phuang1024/BoostConverter/README.md

# BoostConverter

Design, analysis, and build of a boost converter circuit.

[Paper](./paper.pdf)

## Gallery

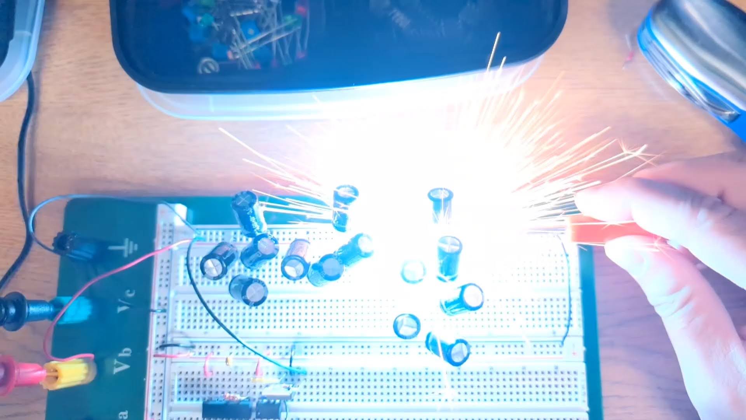
[picture p1: SparkBlue.jpg]


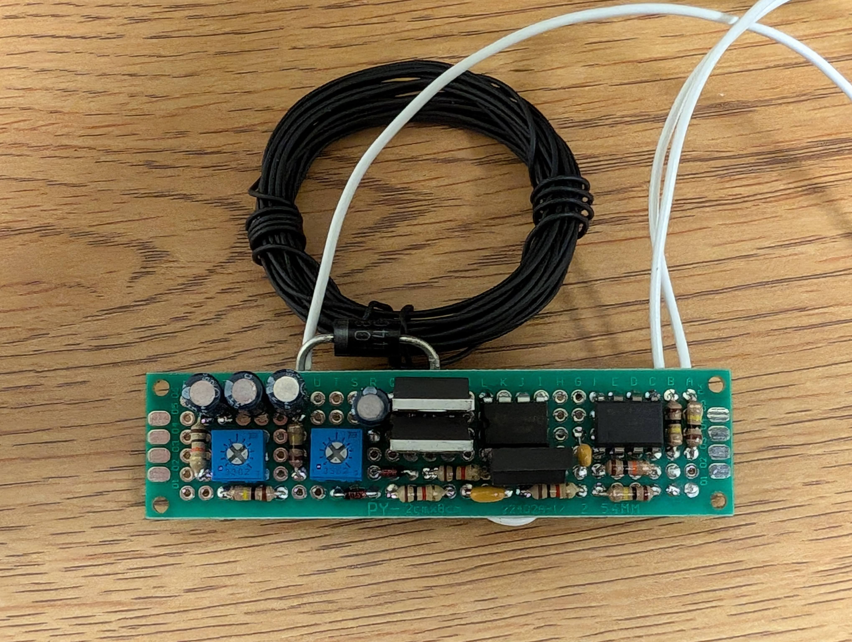
[picture p2: Protoboard.jpg]


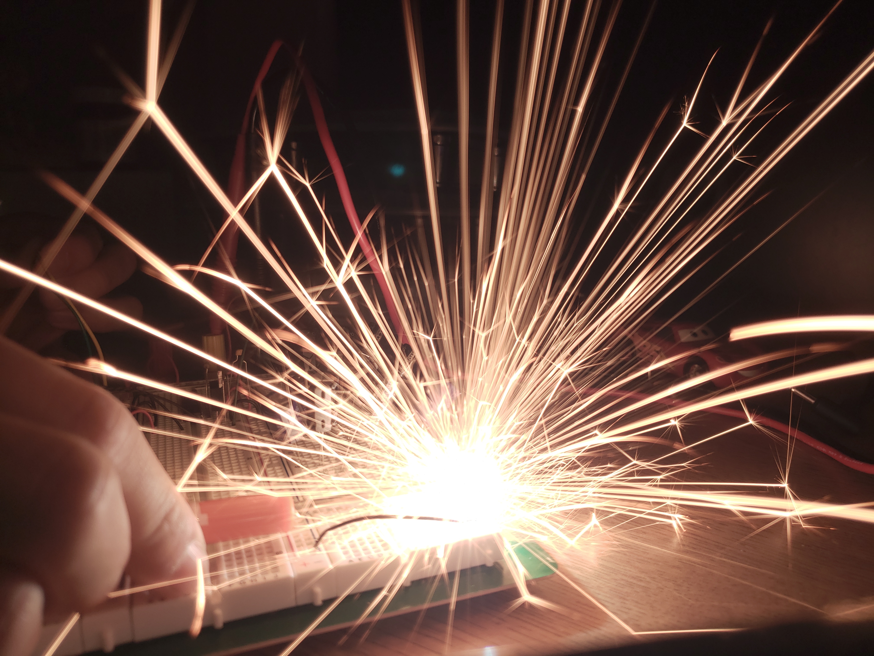
[picture p3: SparkDark.jpg]


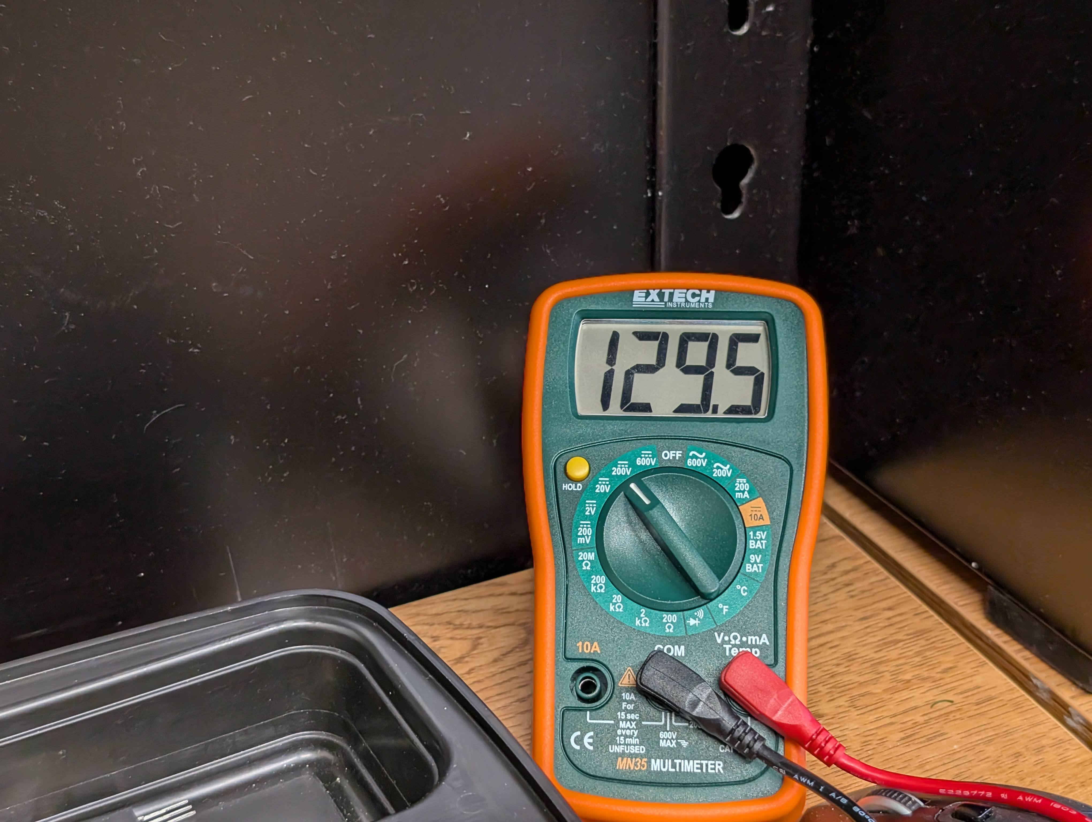
[picture p4: Voltmeter.jpg]
