phuang1024/BoostConverter/schematic.kicad_sch

## KiCad design schematic.kicad_sch (2025-01-09)

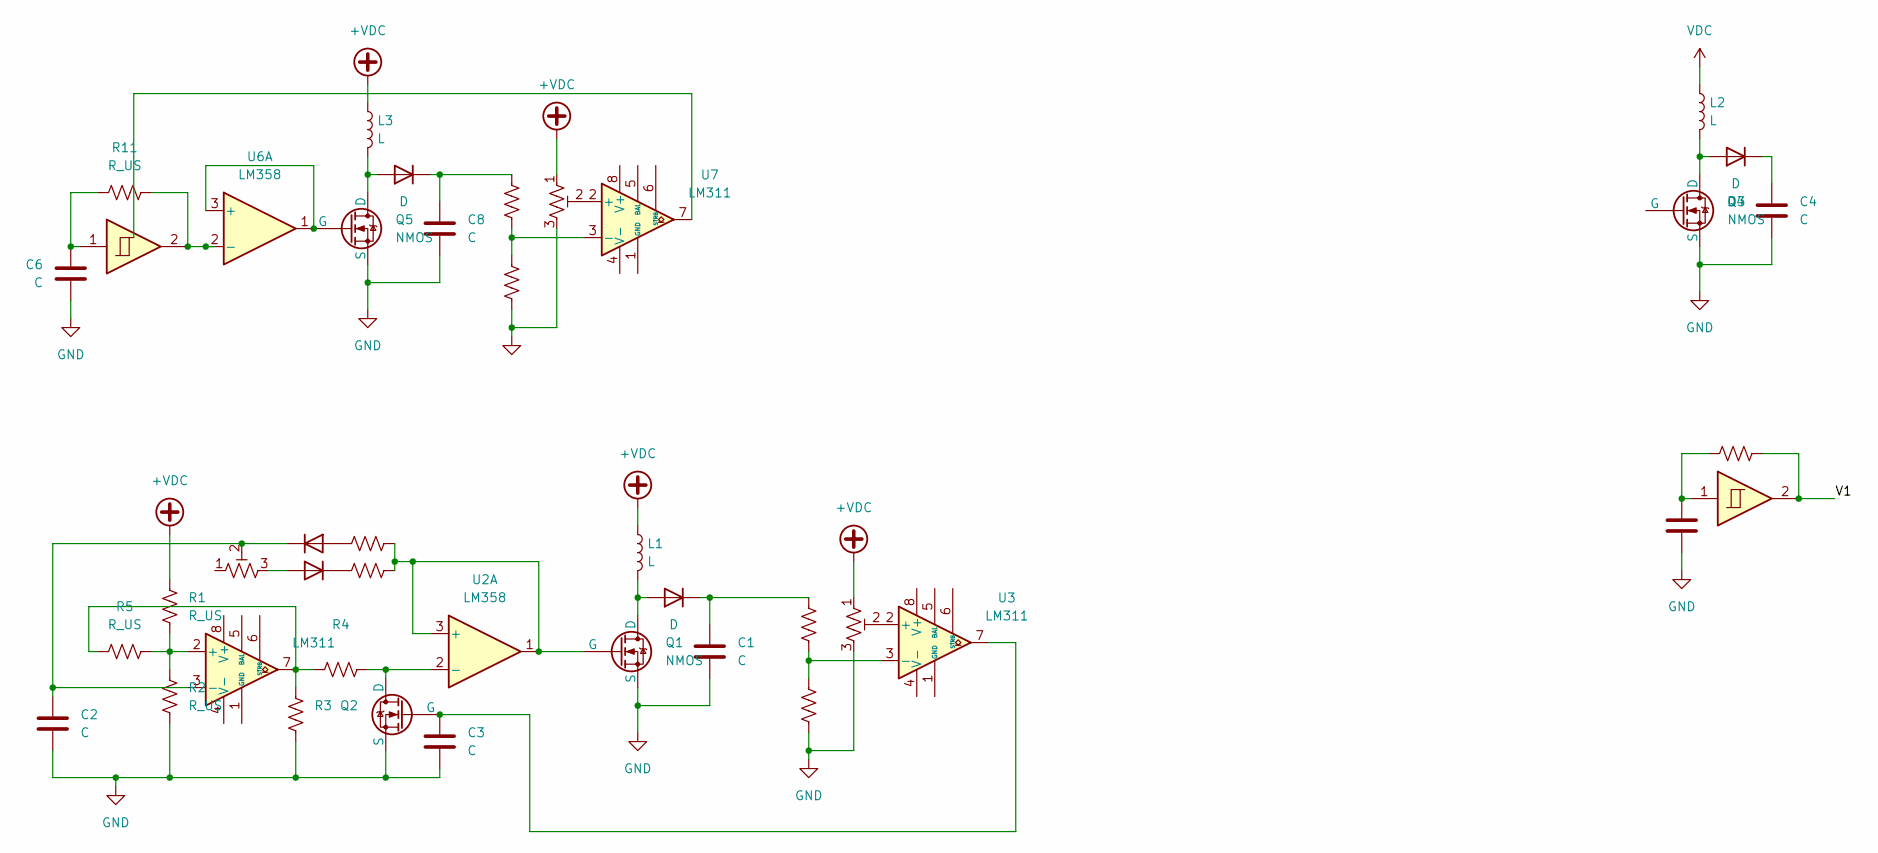
[picture p9: schematic schematic.kicad_sch]

Parts:
C1, C2, C3, C4, C5, C6, C8: C
D1, D4, D7: D
D2, D3: 1N4148WT; D_SOD-523
L1, L2, L3: L
Q1, Q2, Q3, Q5: NMOS
R1, R2, R3, R4, R5, R6, R7, R8, R9, R10, R11, R18, R19: R_US
RV1, RV2, RV4: R_Potentiometer_Trim_US
U1, U3, U7: LM311
U2, U6: LM358
U4, U5: 74HC7014; SOIC-14_3.9x8.7mm_P1.27mm

Connections:
+VDC: L1.1, L3.1, R1.1, RV2.1, RV4.1
GND: C1.2, C2.2, C3.2, C4.2, C5.2, C6.2, C8.2, Q1.3 (S), Q2.3 (S), Q3.3 (S), Q5.3 (S), R2.2, R3.2, R9.2, R19.2, RV2.3, RV4.3
unnamed: C1.1, D1.1 (K), R8.1
unnamed: C2.1, D2.1 (K), RV1.2, U1.3 (-)
unnamed: C3.1, Q2.2 (G), U3.7
unnamed: C4.1, D4.1 (K)
unnamed: C5.1, R10.1, U4.1
unnamed: C6.1, R11.1, U5.1
unnamed: C8.1, D7.1 (K), R18.1
unnamed: D1.2 (A), L1.2, Q1.1 (D)
unnamed: D2.2 (A), R6.1
unnamed: D3.1 (K), R7.1
unnamed: D3.2 (A), RV1.3
unnamed: D4.2 (A), L2.2, Q3.1 (D)
unnamed: D7.2 (A), L3.2, Q5.1 (D)
unnamed: Q1.2 (G), R6.2, R7.2, U2.1, U2.3 (+)
unnamed: Q2.1 (D), R4.2, U2.2 (-)
unnamed: Q5.2 (G), U6.1, U6.3 (+)
unnamed: R1.2, R2.1, R5.2, U1.2 (+)
unnamed: R3.1, R4.1, R5.1, U1.7
unnamed: R8.2, R9.1, U3.3 (-)
unnamed: R11.2, U5.2, U6.2 (-)
unnamed: R18.2, R19.1, U7.3 (-)
unnamed: RV2.2, U3.2 (+)
unnamed: RV4.2, U7.2 (+)
V1: R10.2, U4.2
VDC: L2.1
